alfredkievit/LoRa_Sensor_Binaire_Upload_RAK3172/docs/images/pcb-top-view.jpg

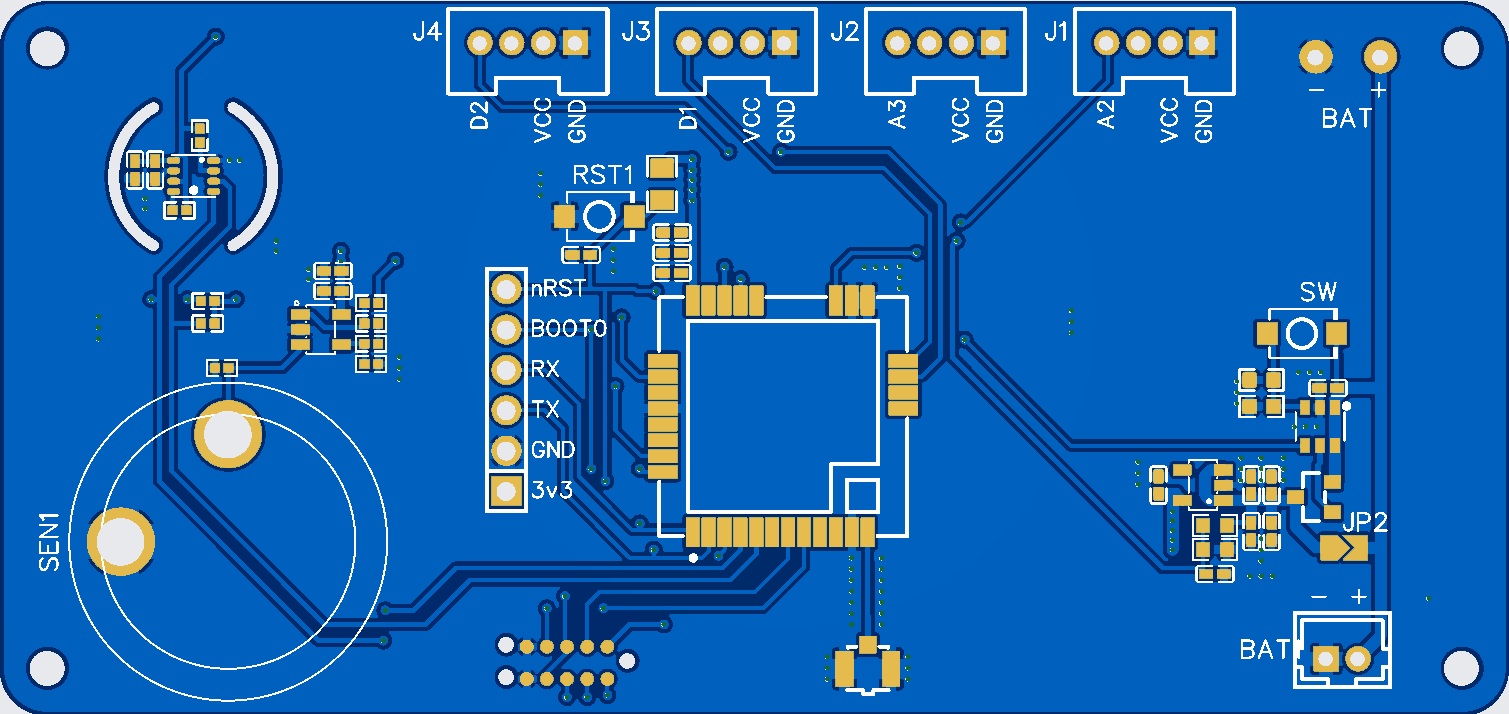
docs/images/pcb-top-view.jpg
