alfredkievit/LoRa_Sensor_Binaire_Upload_RAK3172/docs/hardware/BOM_Aalfredkievit_1_v4_2026-02-02.csv

ID | Name | Designator | Footprint | Quantity | Manufacturer Part | Manufacturer | Supplier | Supplier Part | Price
1 | JP_OPEN | JP3,JP2 | JUMPER_OPEN | 2
2 | 4.7kΩ | R21 | R0402 | 1 | 0402WGF4701TCE | UNI-ROYAL(厚声) | LCSC | C25900 | 0.001
3 | 100nF | C1,C2,C13,C11,C12,C22,C23,C6,C7,C3 | C0402_NEW | 10 | CL05B104KO5NNNC | SAMSUNG | LCSC | C1525 | 0.001
4 | 100Ω | R1 | R0402 | 1 | 0402WGF1000TCE | UNI-ROYAL(厚声) | LCSC | C25076 | 0.001
5 | 100kΩ | R2,R3 | R0402 | 2 | 0402WGF1003TCE | UNI-ROYAL(厚声) | LCSC | C25741 | 0.001
6 | 0Ω | R4,R5,R19,R20 | R0805 | 4 | 0805W8F0000T5E | UNI-ROYAL(厚声) | LCSC | C17477 | 0.002
7 | TS-1088-AR02016 | SW1,RST1 | SW-SMD_L3.9-W3.0-P4.45 | 2 | TS-1088-AR02016 | XUNPU(讯普) | LCSC | C720477 | 0.045
8 | 10uF | C14 | C0402 | 1 | CL05A106MQ5NUNC | SAMSUNG | LCSC | C15525 | 0.005
9 | 0Ω | R14,R18 | R0402 | 2 | 0402WGJ0000TCE | UNI-ROYAL(厚声) | LCSC | C21376 | 0.001
10 | 100Ω | R15,R16 | R0402 | 2 |  | UNI-ROYAL(厚声) | LCSC | C25076 | 0.001
11 | 20kΩ | R17 | R0402 | 1 | FRC0402F2002TS | FOJAN(富捷) | LCSC | C2906867 | 0.001
12 | ME2-O2-Ф20 | SEN1 | ME2-O2-Ф20 | 1
13 | OPA333AIDBVR | U4 | SOT-23-5_L3.0-W1.7-P0.95-LS2.8-BR | 1 | OPA333AIDBVR | TI(德州仪器) | LCSC | C30878 | 0.463
14 | 1uF | C10,C4,C5,C8,C9 | C0402 | 5 | CL05A105KA5NQNC | SAMSUNG(三星) | LCSC | C52923 | 0.003
15 | 100nF | C19 | C0402 | 1 | CL05B104KB54PNC | SAMSUNG(三星) | LCSC | C307331 | 0.004
16 | Header-Male-2.54_1x6 | H1 | HDR-TH_6P-P2.54-V-M-1 | 1 | 2.54-1x6P直针 | BOOMELE(博穆精密) | LCSC | C37208 | 0.037
17 | U.FL-R-SMT-1(80) | JP1 | RF-SMD_FRF05002-JSS103M | 1 | U.FL-R-SMT-1(80) | HRS(广濑) | LCSC | C88374 | 0.129
18 | AO3401A | Q1 | SOT-23_L2.9-W1.3-P1.90-LS2.4-BR | 1 | AO3401A | AOS | LCSC | C15127 | 0.058
19 | 10kΩ | R8,R9,R12,R28 | R0402 | 4 |  | UNI-ROYAL(厚声) | LCSC | C25744 | 0.001
20 | 150kΩ | R10,R11 | R0603 | 2 | 0603WAF1503T5E | UNI-ROYAL(厚声) | LCSC | C22807 | 0.001
21 | 10kΩ | R13 | R0805 | 1 | 0805W8F1002T5E | UNI-ROYAL(厚声) | LCSC | C17414 | 0.002
22 | RAK3172-8-SM-NI | U3 | WIRELM-SMD_32P-L15.5-W15.0-P1.00 | 1 | RAK3172-8-SM-NI | RAK(瑞科慧联) | LCSC | C5452091 | 6.529
23 | - | U5 | TSOT-23-6_L2.9-W1.6-P0.95-LS2.8-BR | 1 | TPL5110QDDCRQ1 | TI(德州仪器) | LCSC | C1539984 | 0.679
24 | TLV75533PDBVR | U8 | SOT-23-5_L3.0-W1.7-P0.95-LS2.8-BR | 1 | TLV75533PDBVR | TI(德州仪器) | LCSC | C404027 | 0.107
25 | HDGC2001WV-2P | BAT1 | CONN-TH_2P-P2.00_HDGC_HDGC2001WV-2P | 1 | HDGC2001WV-2P | HDGC(华德共创) | LCSC | C5175230 | 0.008
26 | BME280 | U11 | LGA-8_BME280_BL | 1 |  | Bosch(博世) | LCSC | C92489 | 4.655
27 | 470kΩ | R6 | R0603 | 1 | 0603WAF4703T5E | UNI-ROYAL(厚声) | LCSC | C23178 | 0.001
28 | 1.5MΩ | R7 | R0603 | 1 | 0603WAF1504T5E | UNI-ROYAL(厚声) | LCSC | C4172 | 0.002
29 | B04B-PASK(LF)(SN) | J1,J2,J3,J4 | CONN-TH_B04B-PASK-LF-SN | 4 | B04B-PASK(LF)(SN) | JST | LCSC | C265078 | 0.164
