alfredkievit/LoRa_Sensor_Binaire_Upload_RAK3172/docs/hardware/Schematic_Aalfredkievit_1_v4_2026-02-02.pdf

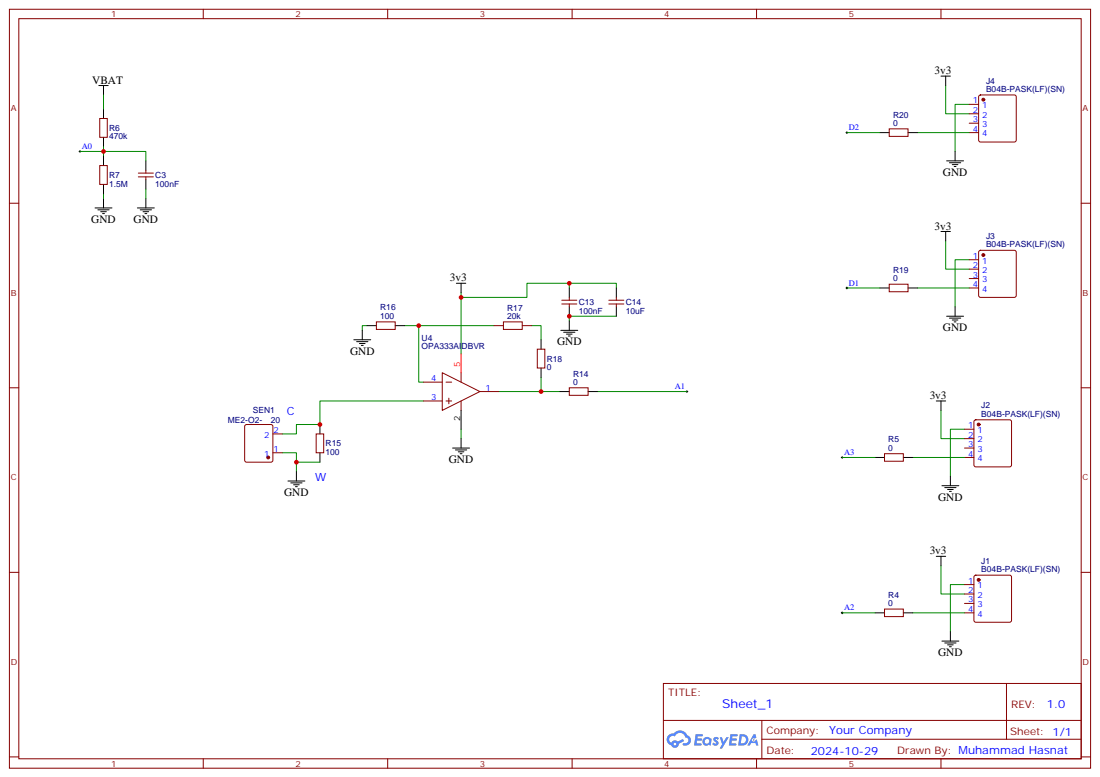
[picture p4: page 1]

Drawn By: Muhammad Hasnat

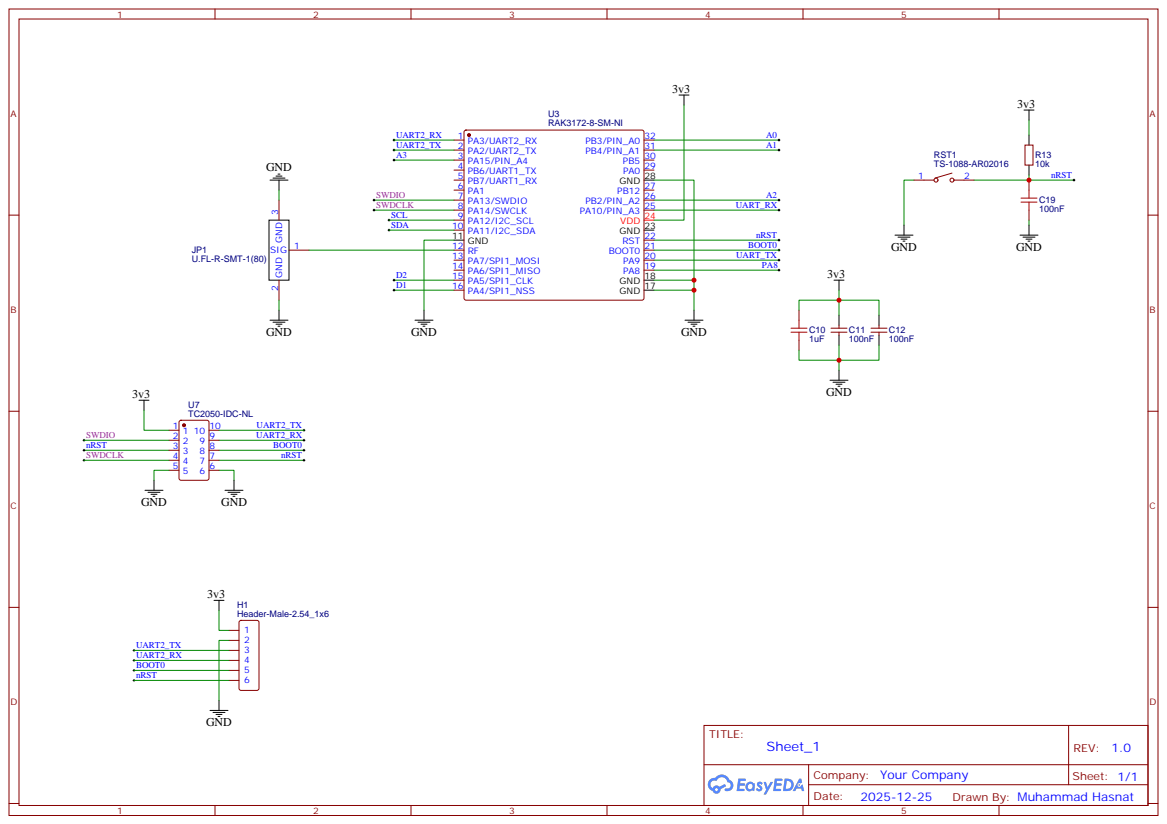
[picture p5: page 2]

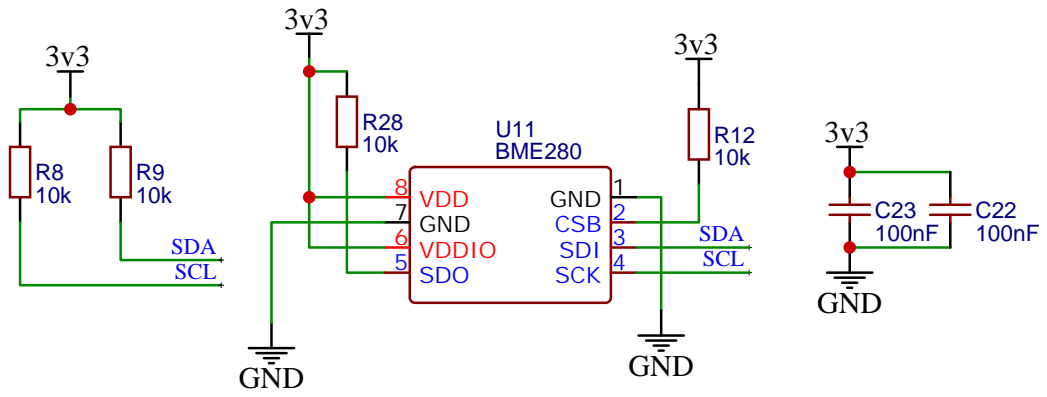
[picture p6: page 3]

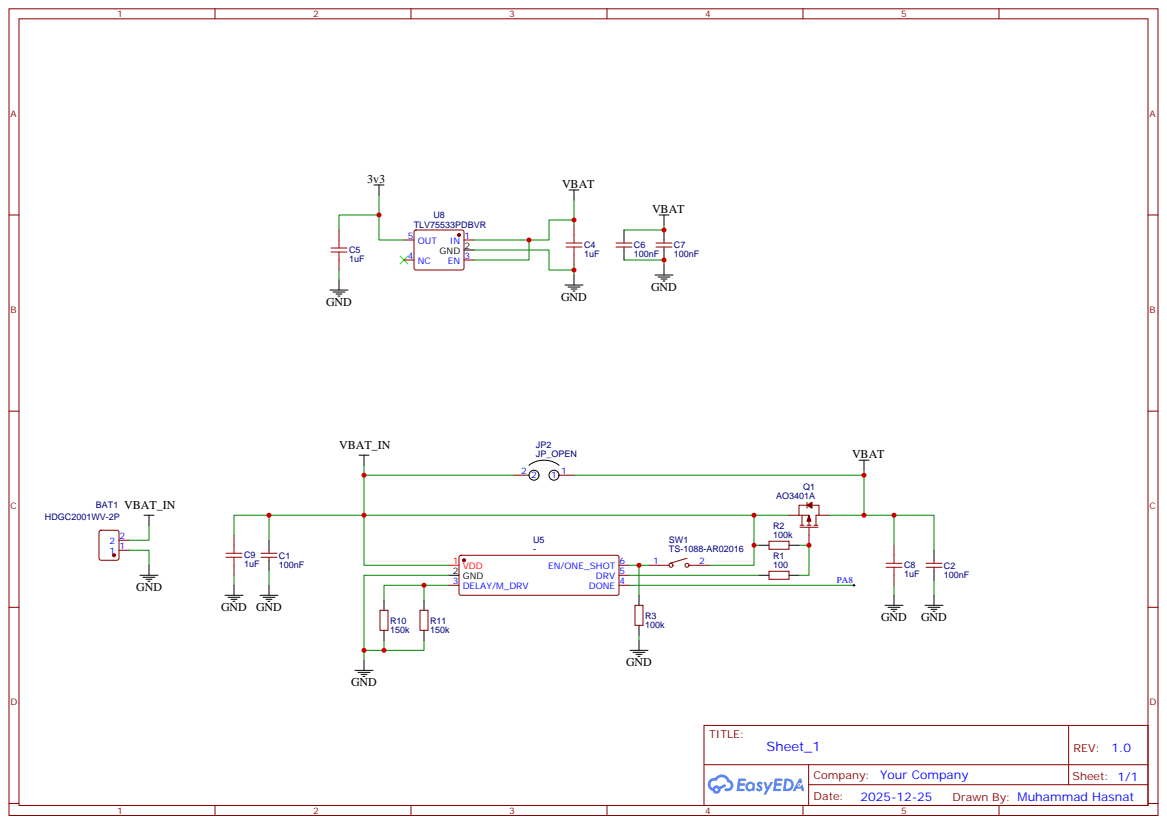
[picture p7: page 4]
