alfredkievit/LoRa_Sensor_Binaire_Upload_RAK3172/docs/hardware/Schematic_Aalfredkievit_1_v4_2025-12-30.pdf

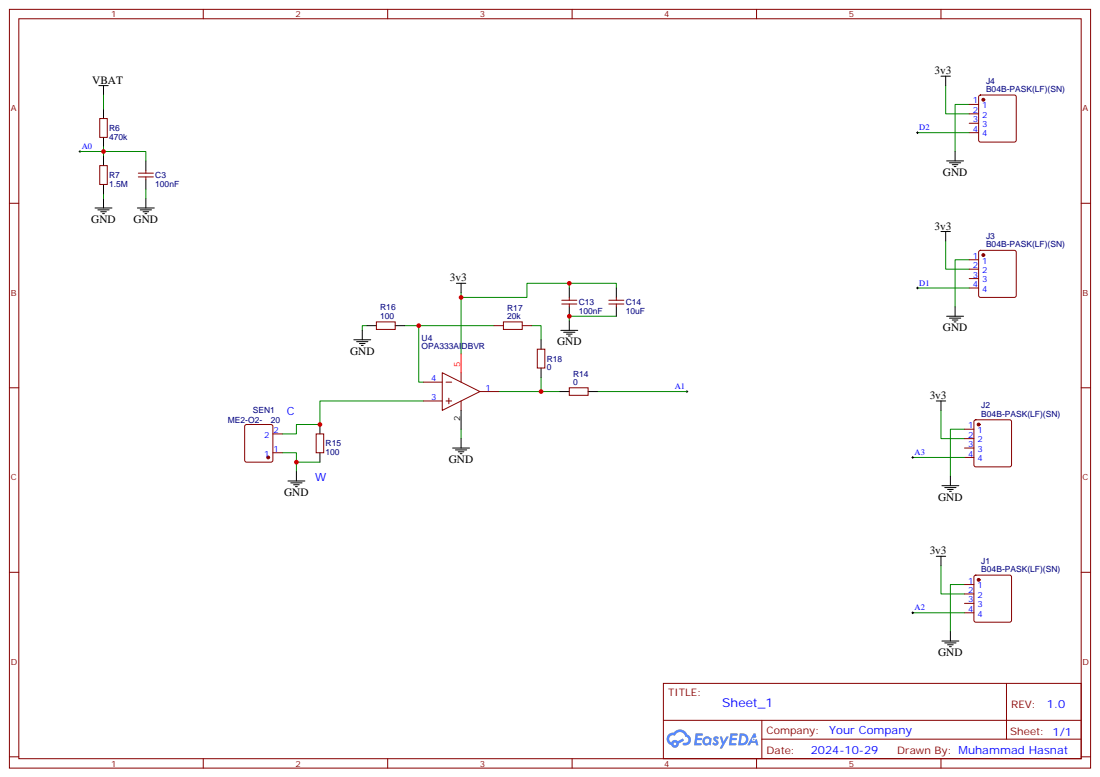
[picture p8: page 1]

Drawn By: Muhammad Hasnat

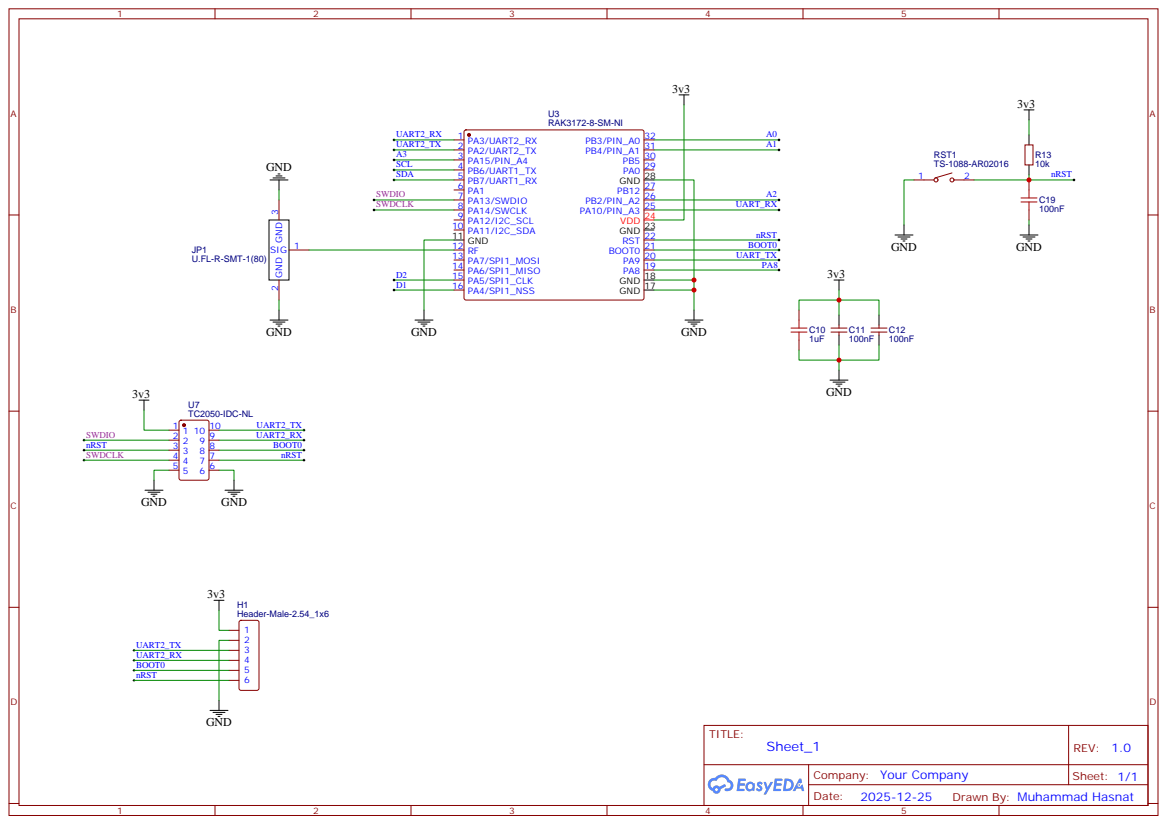
[picture p9: page 2]

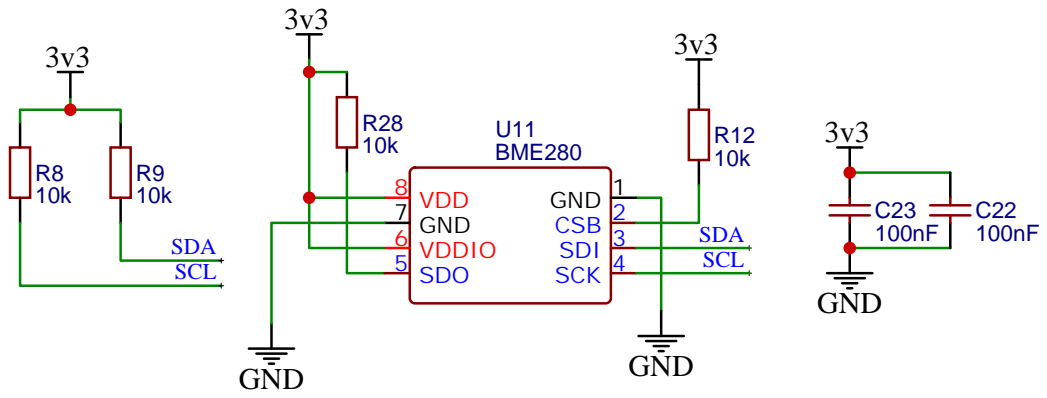
[picture p10: page 3]

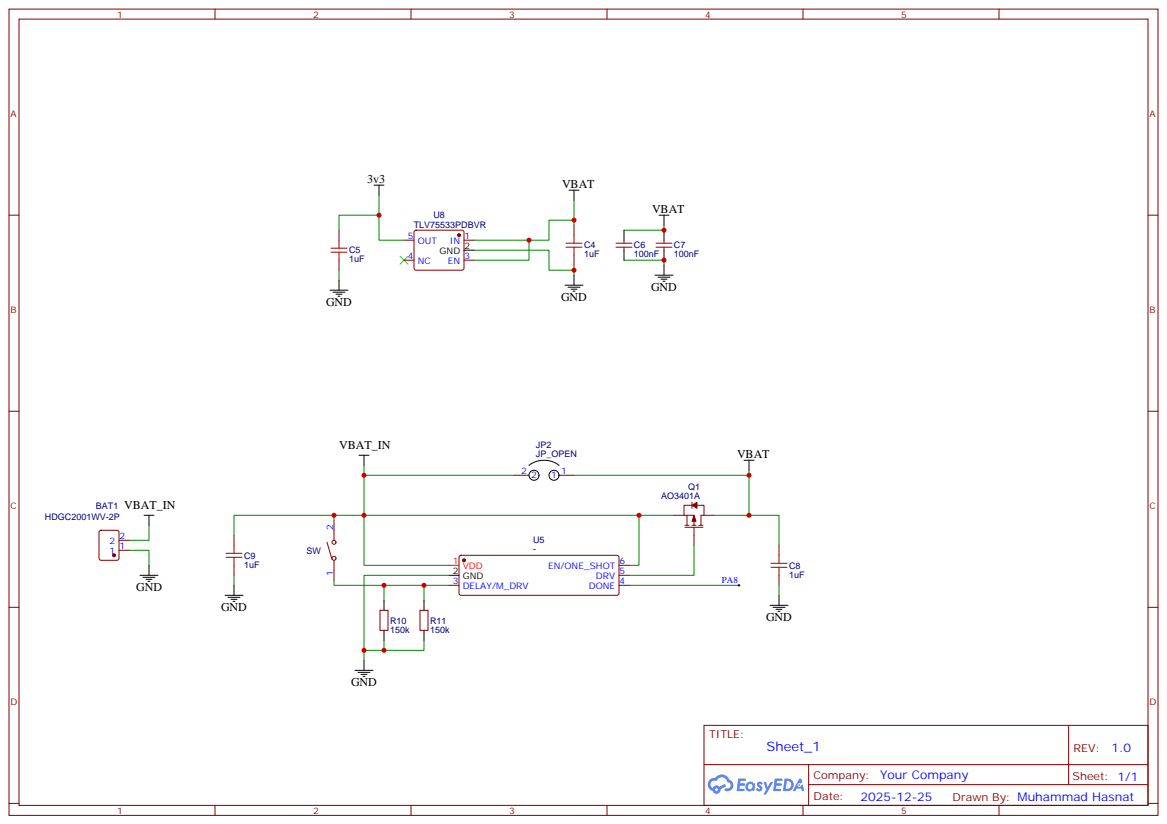
[picture p11: page 4]
