alfredkievit/LoRa_Sensor_Binaire_Upload_RAK3172/RAK3172_Binaire_payload_rui/arduino_secrets.example.h

#ifndef ARDUINO_SECRETS_EXAMPLE_H
#define ARDUINO_SECRETS_EXAMPLE_H

// Copy this file to arduino_secrets.h and fill in the real OTAA keys.
// SECRET_DEV_EUI must be exactly 16 hex chars (8 bytes, MSB first).
// SECRET_APP_EUI must be exactly 16 hex chars (8 bytes, MSB first).
// SECRET_APP_KEY must be exactly 32 hex chars (16 bytes, MSB first).

#define SECRET_DEV_EUI "0000000000000000"
#define SECRET_APP_EUI "0000000000000000"
#define SECRET_APP_KEY "00000000000000000000000000000000"

#endif
