alfredkievit/LoRa_Sensor_Binaire_Upload_RAK3172/(commit log)

2026-06-12 Update hardware documentation and production files for v2
    [BOM_Aalfredkievit_1_v4_2026-02-02.csv]
2026-06-12 docs: add VS Code upload workflow and calibration notes
2026-06-13 refactor: consolidate Arduino sketch into canonical sketch folder
    Move the tracked sketch and example secrets file into RAK3172_Binaire_payload_rui/, update the VS Code Arduino configuration to use the sketch from that folder, and enable Arduino CLI mode for the community extension.
    Also refresh the README and legacy VS Code notes so build/upload instructions and secrets paths match the new layout. Verified with arduino-cli compile against the RAK3172 RUI board configuration.
2026-06-13 Clean up sketch layout and add service-pin calibration mode
2026-06-15 firmware: refine debug calibration and stabilize O2 reads
2026-10-26 firmware: match MKR1310 feature set and fix pinmap for board v4
    Pinmap per schematic v4: O2 is read on PB4 (OPA333 output), not PB2 (J1).
    PA8 is the TPL5110 DONE input, not a sensor supply: driving it high cut
    VBAT. It is now held low; the node uses RUI sleep and needs JP2 bridged.
    Ported from LoRa_Sensor_Binaire_Upload (fix/o2-low-readings):
    - O2-A2 temperature compensation, calibration temp stored with the
    reference in RUI user flash (magic + checksum)
    - calibration warm-up and stability window, O2Status validation
    - low O2 down to 0.0 % is valid; open-circuit probe below 50 counts
    - missing BME280 sends O2/battery with 0x7FFF/0xFFFF markers, I2C bus
    recovery and init retry
    - battery-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
